martonmiklos/ble_blind_mover/README.md

## BLE blind mover

Control circuit designed to drive a Rollomatic Rollotube Tubular motor.

Design goals:
 - RTC feature for timed blind moving
 - BLE connectivity for programming and RTC sync
 - Integrated isolated 230V power supply for the low voltage parts
