martonmiklos/ble_blind_mover/ble_blind_mover.pdf

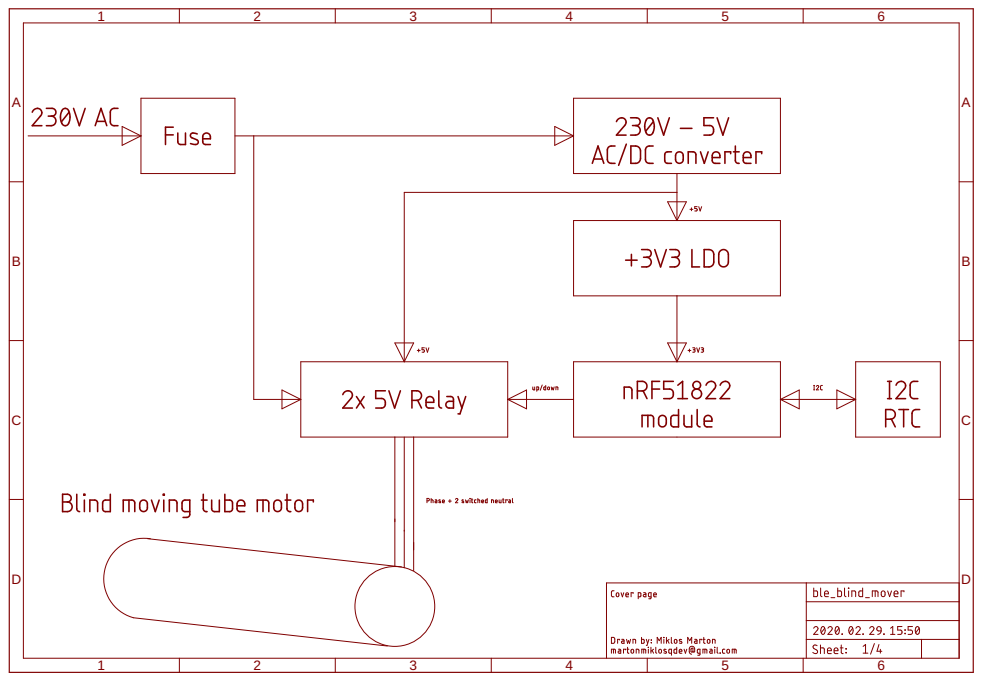
[picture p1: page 1]

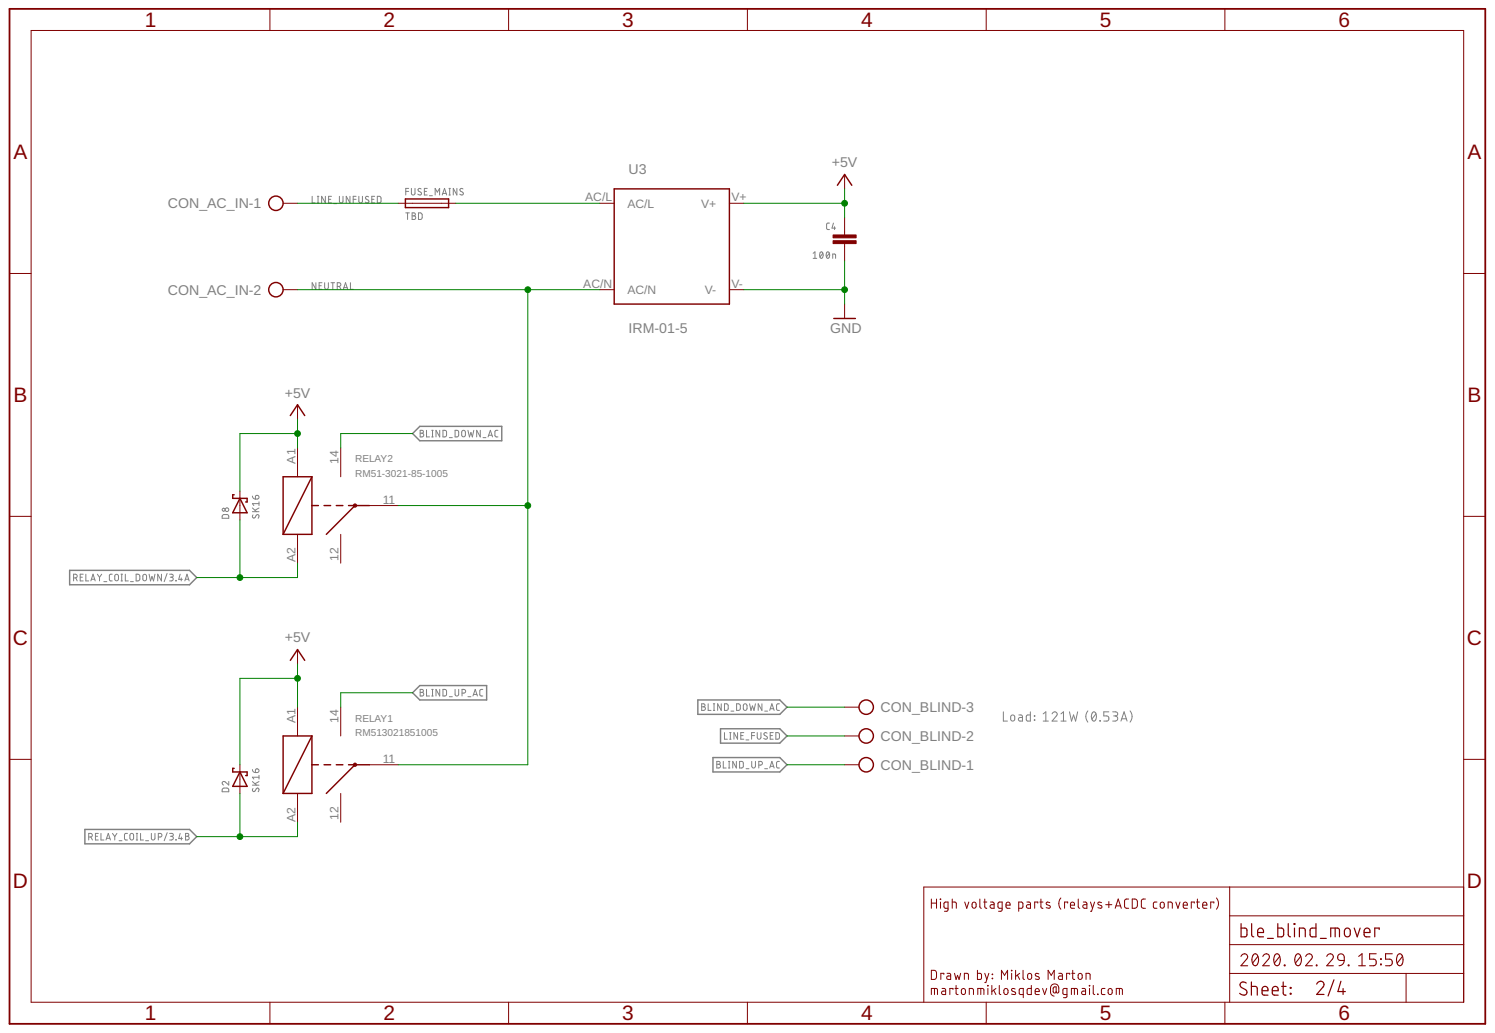
[picture p2: page 2]

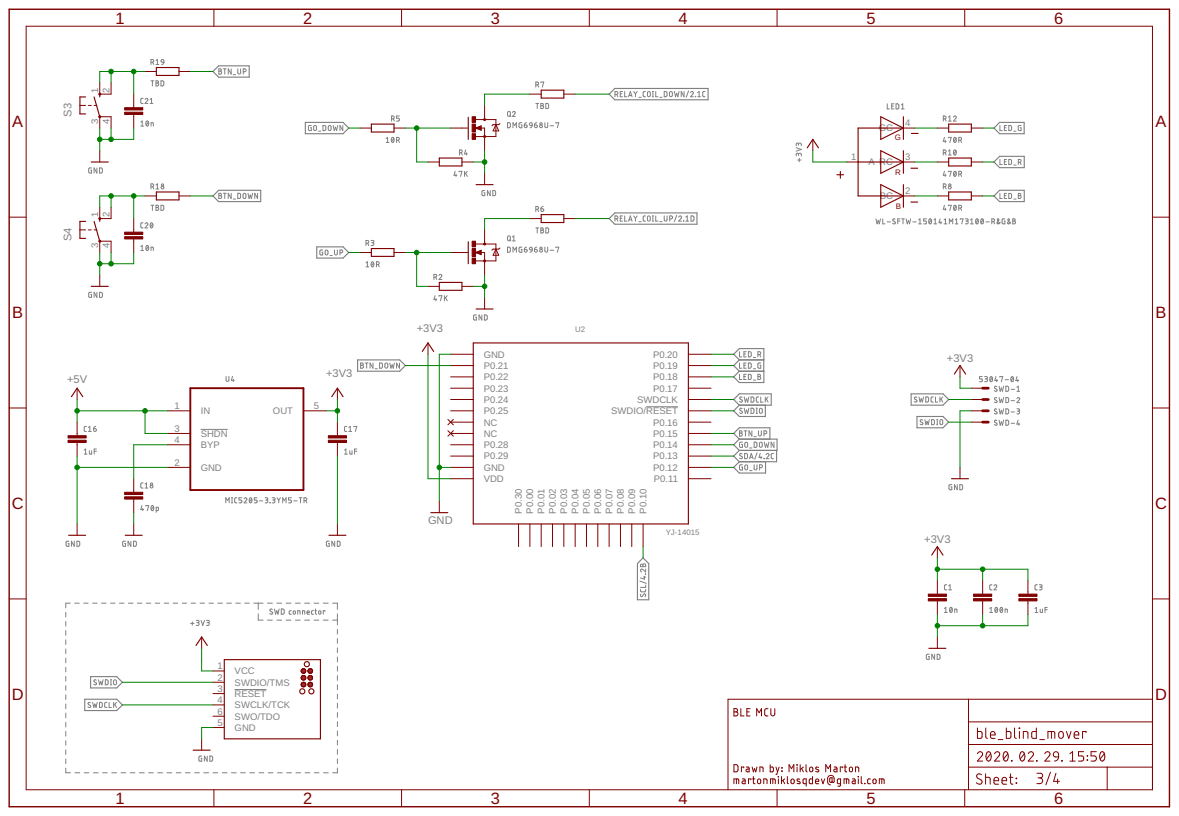
[picture p3: page 3]

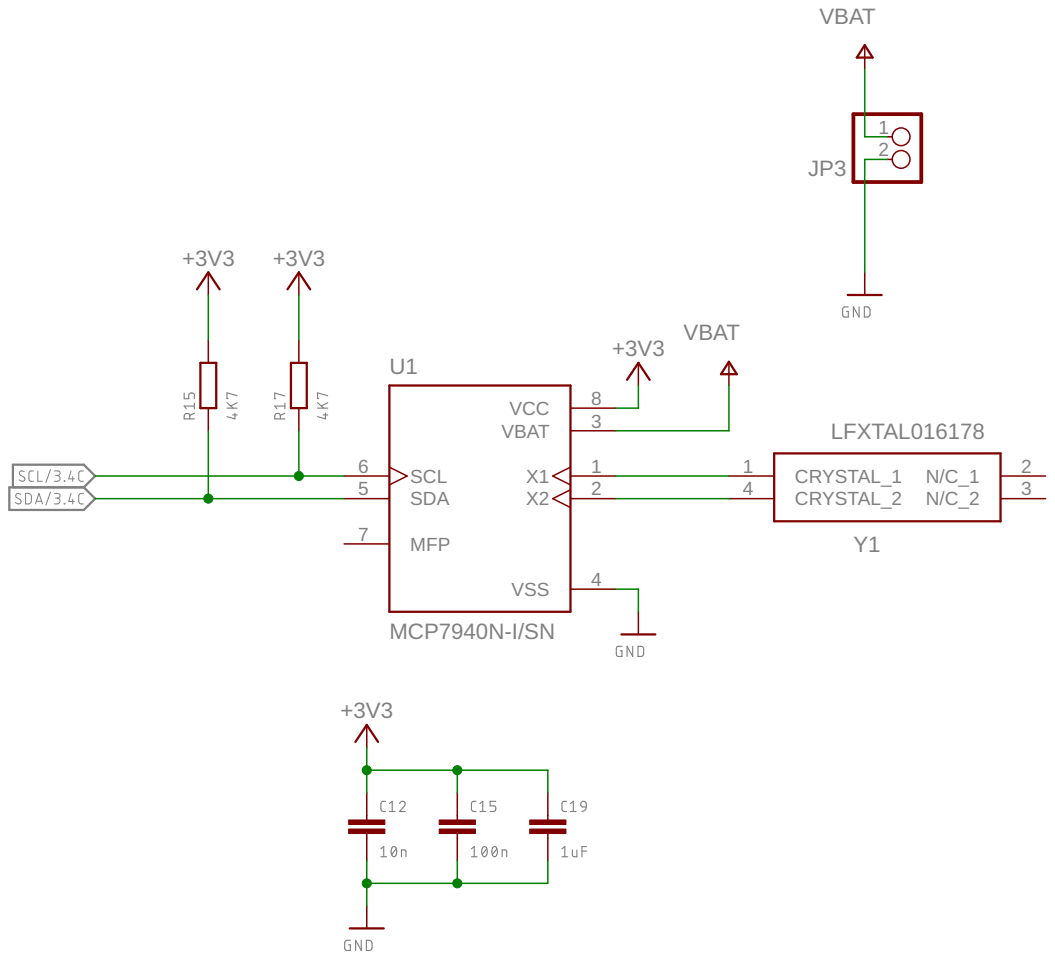
[picture p4: page 4]
