martonmiklos/ble_blind_mover/ble_blind_mover.brd

## EAGLE design ble_blind_mover.brd (2021-05-05)

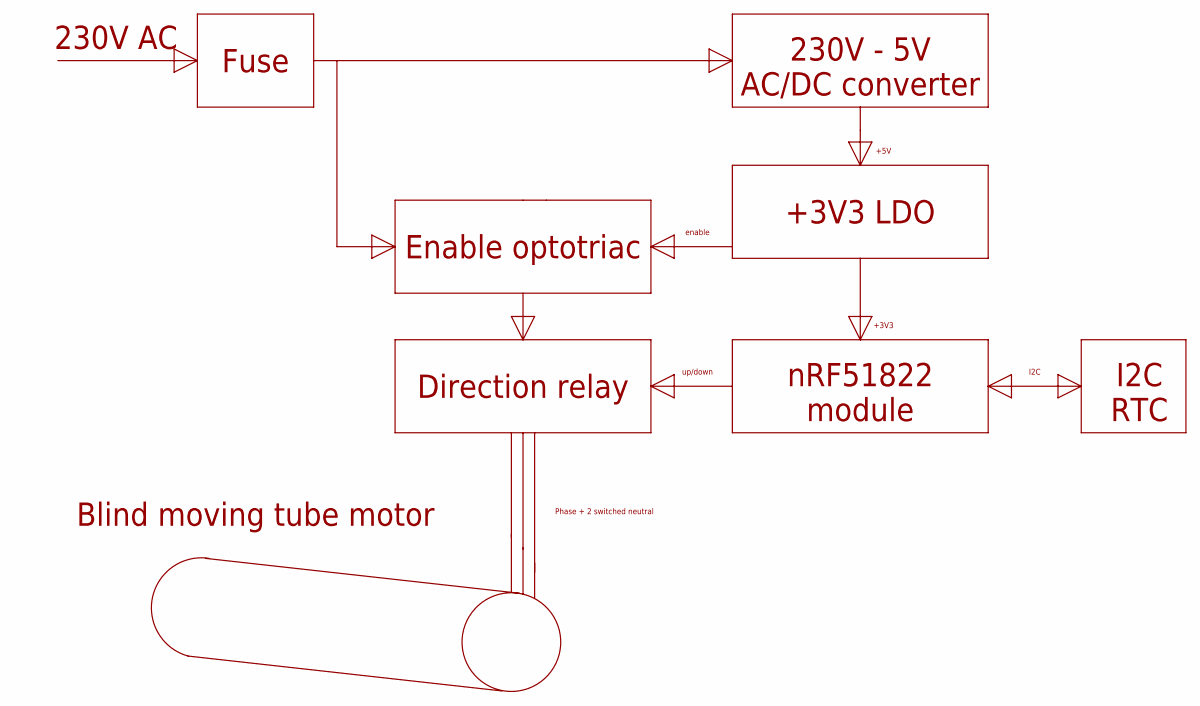
[picture p5: schematic ble_blind_mover.sch, sheet 1, Cover page]

Notes on the sheet:
Fuse
230V AC
230V - 5V AC/DC converter
Direction relay
nRF51822 module
Blind moving tube motor
up/down
+5V
Phase + 2 switched neutral
I2C RTC
I2C
+3V3 LDO
+3V3
Enable optotriac
enable

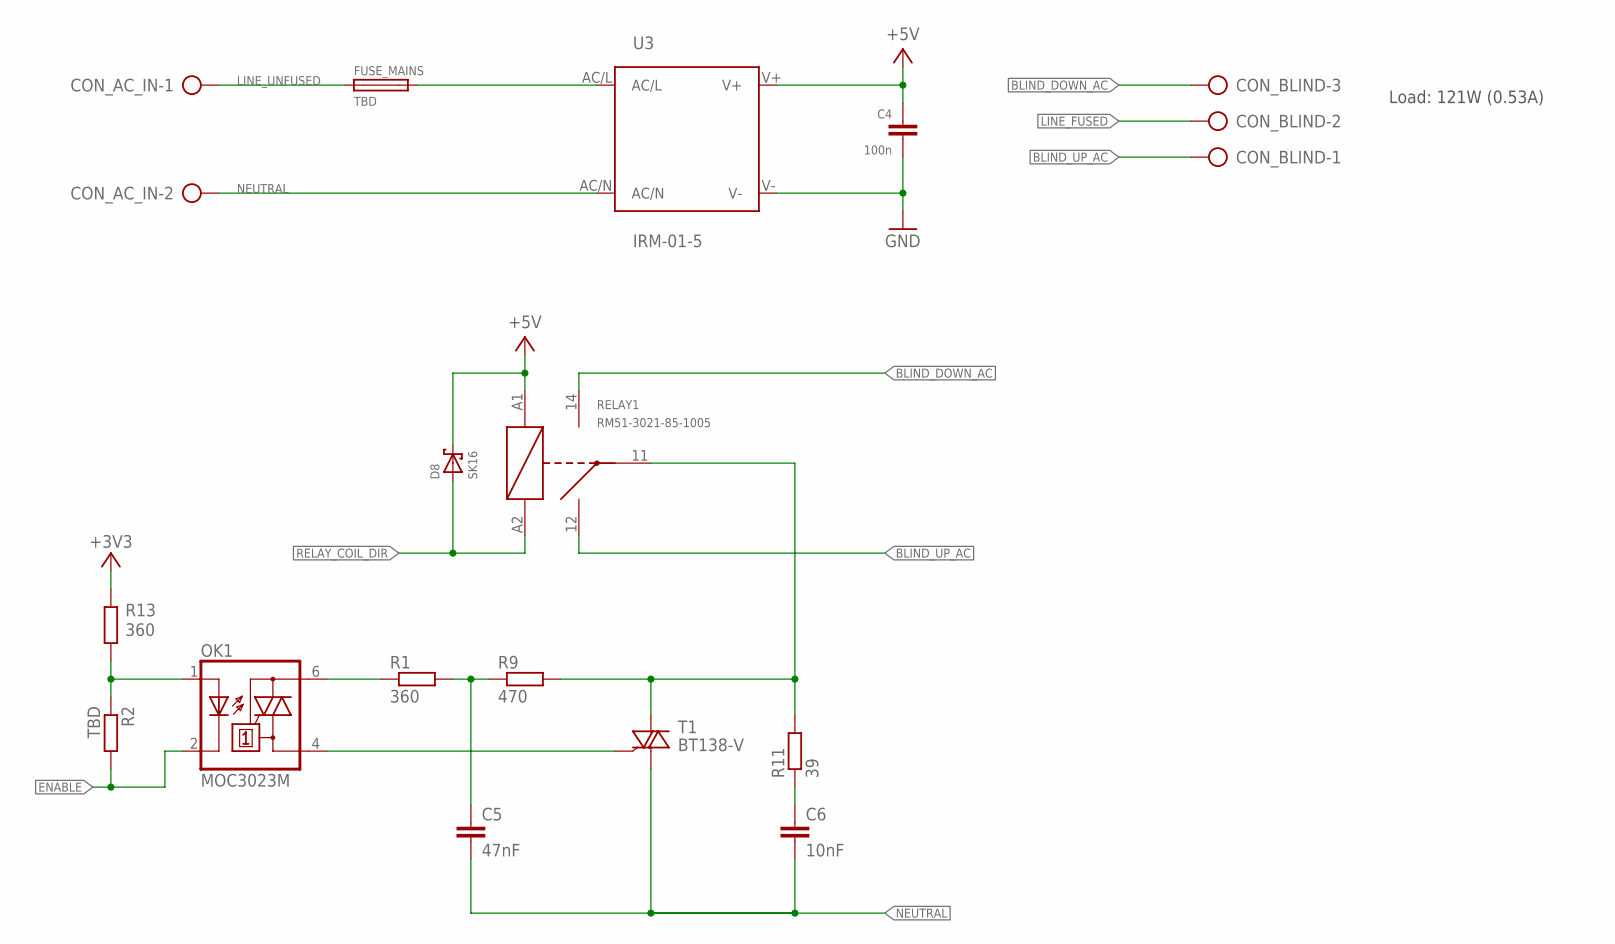
[picture p6: schematic ble_blind_mover.sch, sheet 2, High voltage parts (relays+ACDC converter)]

Parts:
C4: 100n; C0603
C5: 47nF; C025-030X050
C6: 10nF; C025-030X050
CON_AC_IN: AK500/2
CON_BLIND: AK500/3
D8: SK16; DO-214AC
FUSE_MAINS: TBD; SH22,5
OK1: MOC3023M; DIL06
R1: 360; R0805
R2: TBD; R0603
R9: 470; R0805
R11: 39; 0204V
R13: 360; R0603
RELAY1: RM51-3021-85-1005; RM50-3011-XX-XXXX
T1: BT138-V; TO220BV
U3: IRM-01-5; IRM_01/02

Connections:
+3V3: R13.1; also elsewhere on the board
+5V: C4.1, D8.C, RELAY1.A1, U3.V+; also elsewhere on the board
BLIND_DOWN_AC: CON_BLIND.3, RELAY1.14
BLIND_UP_AC: CON_BLIND.1, RELAY1.12
ENABLE: OK1.2 (C), R2.2; also elsewhere on the board
GND: C4.2, U3.V-; also elsewhere on the board
LINE_FUSED: CON_BLIND.2, FUSE_MAINS.2, U3.AC/L
LINE_UNFUSED: CON_AC_IN.1, FUSE_MAINS.1
LOAD_B: R9.2, R11.2, RELAY1.11, T1.T2 (A2)
MOC_AN: OK1.1 (A), R2.1, R13.2
MOC_OUT: OK1.6 (A2), R1.1
unnamed: C5.1, R1.2, R9.1
NEUTRAL: C5.2, C6.2, CON_AC_IN.2, T1.T1 (A1), U3.AC/N
RELAY_COIL_DIR: D8.A, RELAY1.A2; also elsewhere on the board
SNUB_MID: C6.1, R11.1
TRIAC_GET: OK1.4 (A1), T1.G

Notes on the sheet:
Load: 121W (0.53A)

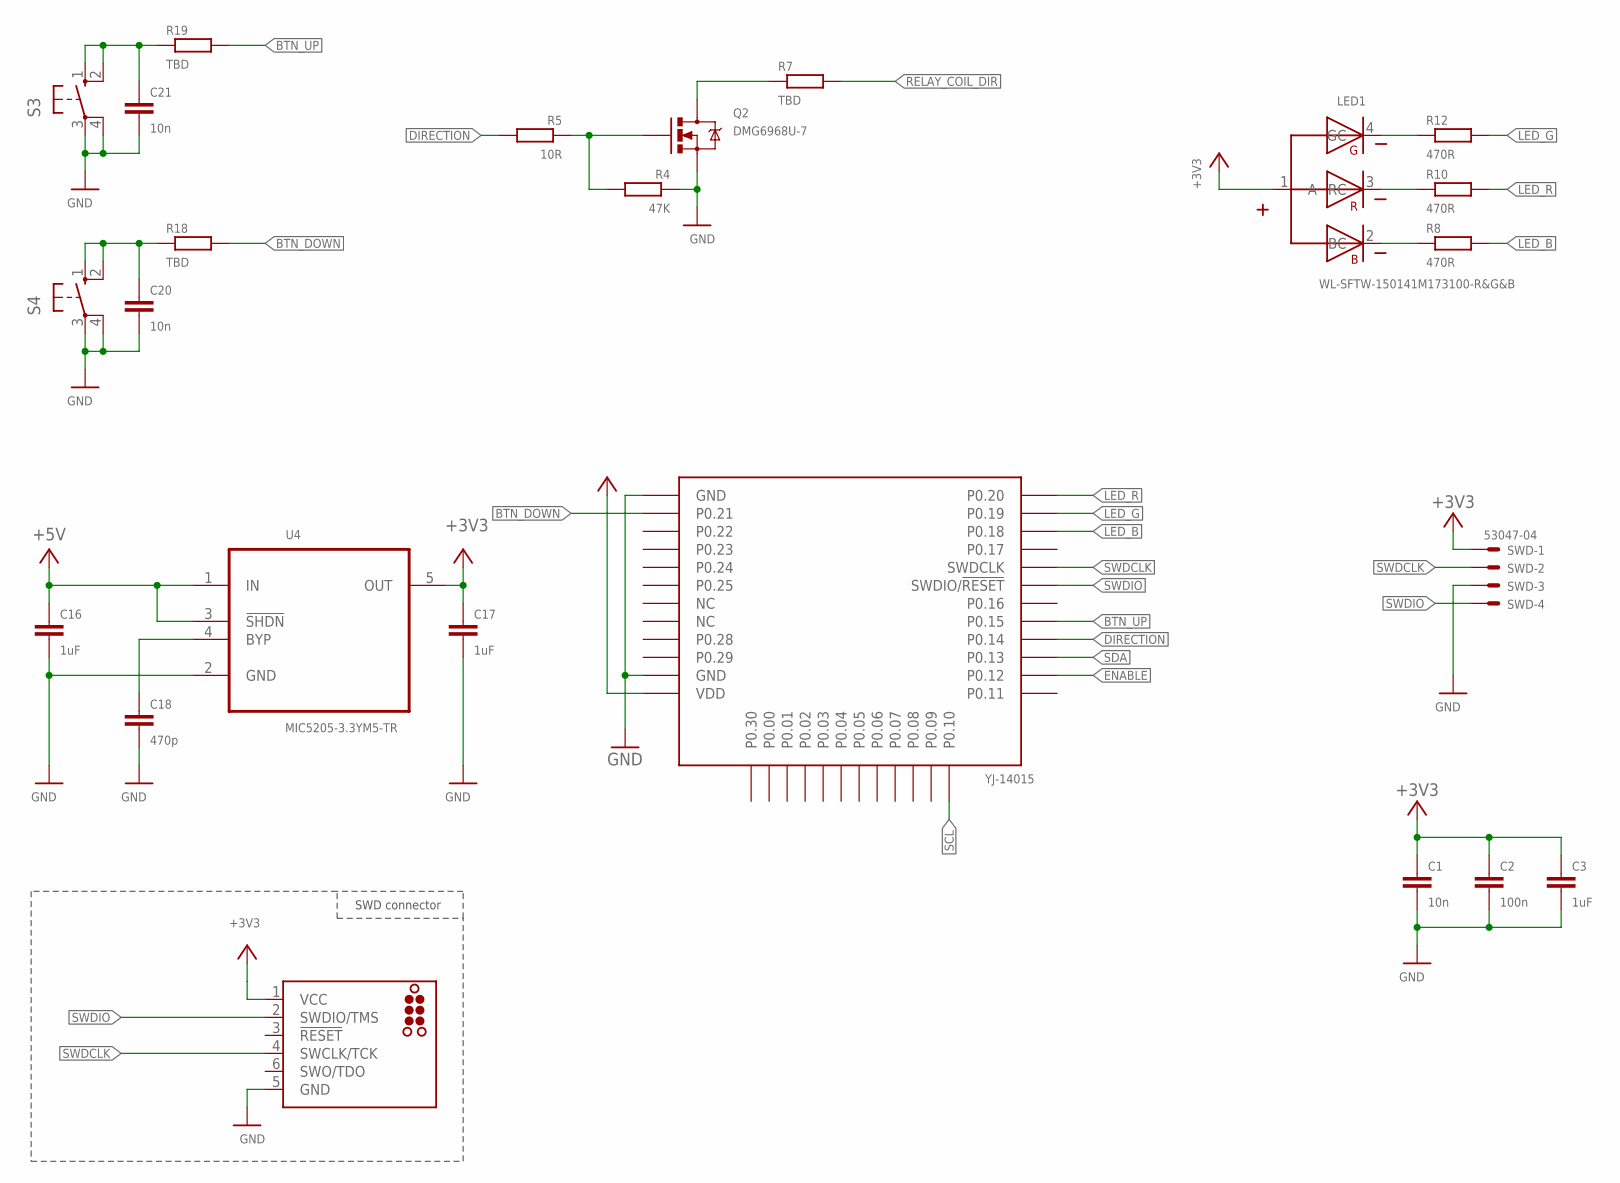
[picture p7: schematic ble_blind_mover.sch, sheet 3, BLE MCU]

Parts:
C1, C20, C21: 10n; C0603
C2: 100n; C0603
C3, C16, C17: 1uF; C0603
C18: 470p; C0603
J2: TC2030_SWD-MCP-NL; TC2030-MCP-NL
LED1: WL-SFTW-150141M173100-R&G&B; 3528-COMMON-ANODE
Q2: DMG6968U-7; SOT23-3
R4: 47K; R0603
R5: 10R; R0603
R7, R18, R19: TBD; R0603
R8, R10, R12: 470R; R0603
S3, S4: 10-XX; B3F-10XX
SWD: 53047-04
U2: YJ-14015
U4: MIC5205-3.3YM5-TR; SOT95P280X145-5N

Connections:
+3V3: C1.1, C2.1, C3.1, C17.1, J2.1 (VCC), LED1.1 (A), SWD.1, U2.VDD, U4.5 (OUT); also elsewhere on the board
+5V: C16.1, U4.1 (IN), U4.3 (!SHDN); also elsewhere on the board
BTN_DOWN: R18.2, U2.P.21 (P0.21)
BTN_DOWN_R: C20.1, R18.1, S4.1 (S), S4.2 (S1)
BTN_UP: R19.2, U2.P.15 (P0.15)
BTN_UP_R: C21.1, R19.1, S3.1 (S), S3.2 (S1)
DIRECTION: R5.2, U2.P.14 (P0.14)
ENABLE: U2.P.12 (P0.12); also elsewhere on the board
GND: C1.2, C2.2, C3.2, C16.2, C17.2, C18.2, C20.2, C21.2, J2.5 (GND), Q2.2 (S), R4.1, S3.3, S3.4 (P1), S4.3, S4.4 (P1), SWD.3, U2.GND, U2.GND@2 (GND), U4.2 (GND); also elsewhere on the board
LED2_B_R: LED1.2 (BC), R8.1
LED2_G_R: LED1.4 (GC), R12.1
LED2_R_R: LED1.3 (RC), R10.1
LED_B: R8.2, U2.P.18 (P0.18)
LED_G: R12.2, U2.P.19 (P0.19)
LED_R: R10.2, U2.P.20 (P0.20)
MOTOR_B_GATE_R: Q2.1 (G), R4.2, R5.1
RELAY_COIL_DIR: R7.2; also elsewhere on the board
RELAY_COIL_DIR_R: Q2.3 (D), R7.1
SCL: U2.P.10 (P0.10); also elsewhere on the board
SDA: U2.P.13 (P0.13); also elsewhere on the board
SWDCLK: J2.4 (SWCLK/TCK), SWD.2, U2.SWDCLK
SWDIO: J2.2 (SWDIO/TMS), SWD.4, U2.SWDIO (SWDIO/!RESET)
U4_BYPASS: C18.1, U4.4 (BYP)

Notes on the sheet:
SWD connector

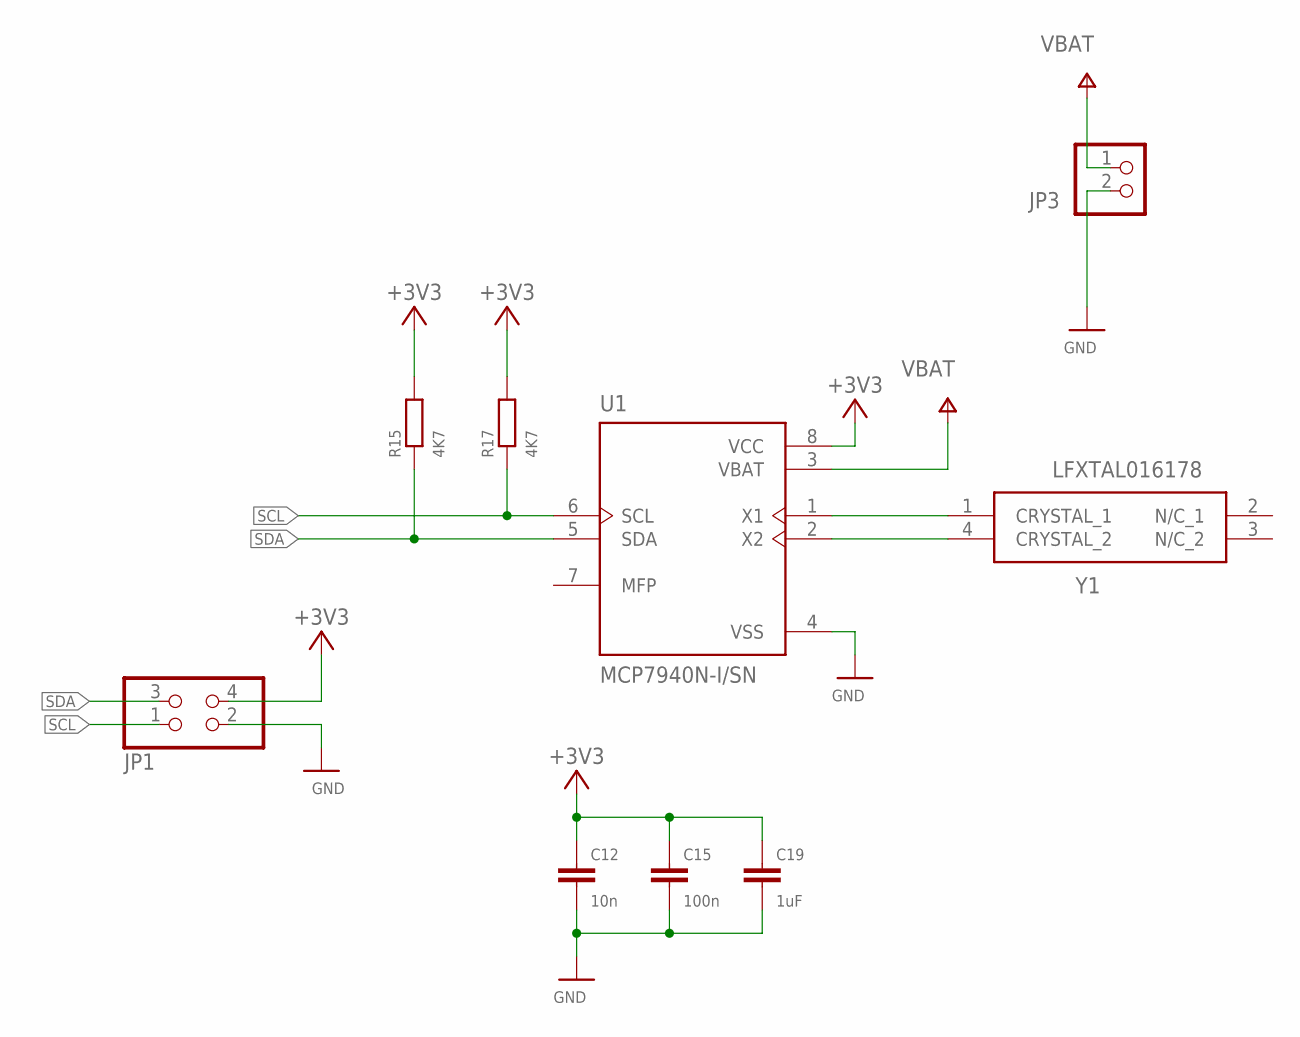
[picture p8: schematic ble_blind_mover.sch, sheet 4, I2C RTC]

Parts:
C12: 10n; C0603
C15: 100n; C0603
C19: 1uF; C0603
JP1: PINHD-2X2; 2X02
JP3: PINHD-1X2; 1X02
R15, R17: 4K7; R0603
U1: MCP7940N-I/SN; SOIC127P600X175-8N
Y1: LFXTAL016178; LFXTAL016178_1

Connections:
+3V3: C12.1, C15.1, C19.1, JP1.4, R15.2, R17.2, U1.8 (VCC); also elsewhere on the board
GND: C12.2, C15.2, C19.2, JP1.2, JP3.2, U1.4 (VSS); also elsewhere on the board
RTC_XTAL1: U1.1 (X1), Y1.1 (CRYSTAL_1)
RTC_XTAL2: U1.2 (X2), Y1.4 (CRYSTAL_2)
SCL: JP1.1, R17.1, U1.6 (SCL); also elsewhere on the board
SDA: JP1.3, R15.1, U1.5 (SDA); also elsewhere on the board
VBAT: JP3.1, U1.3 (VBAT)

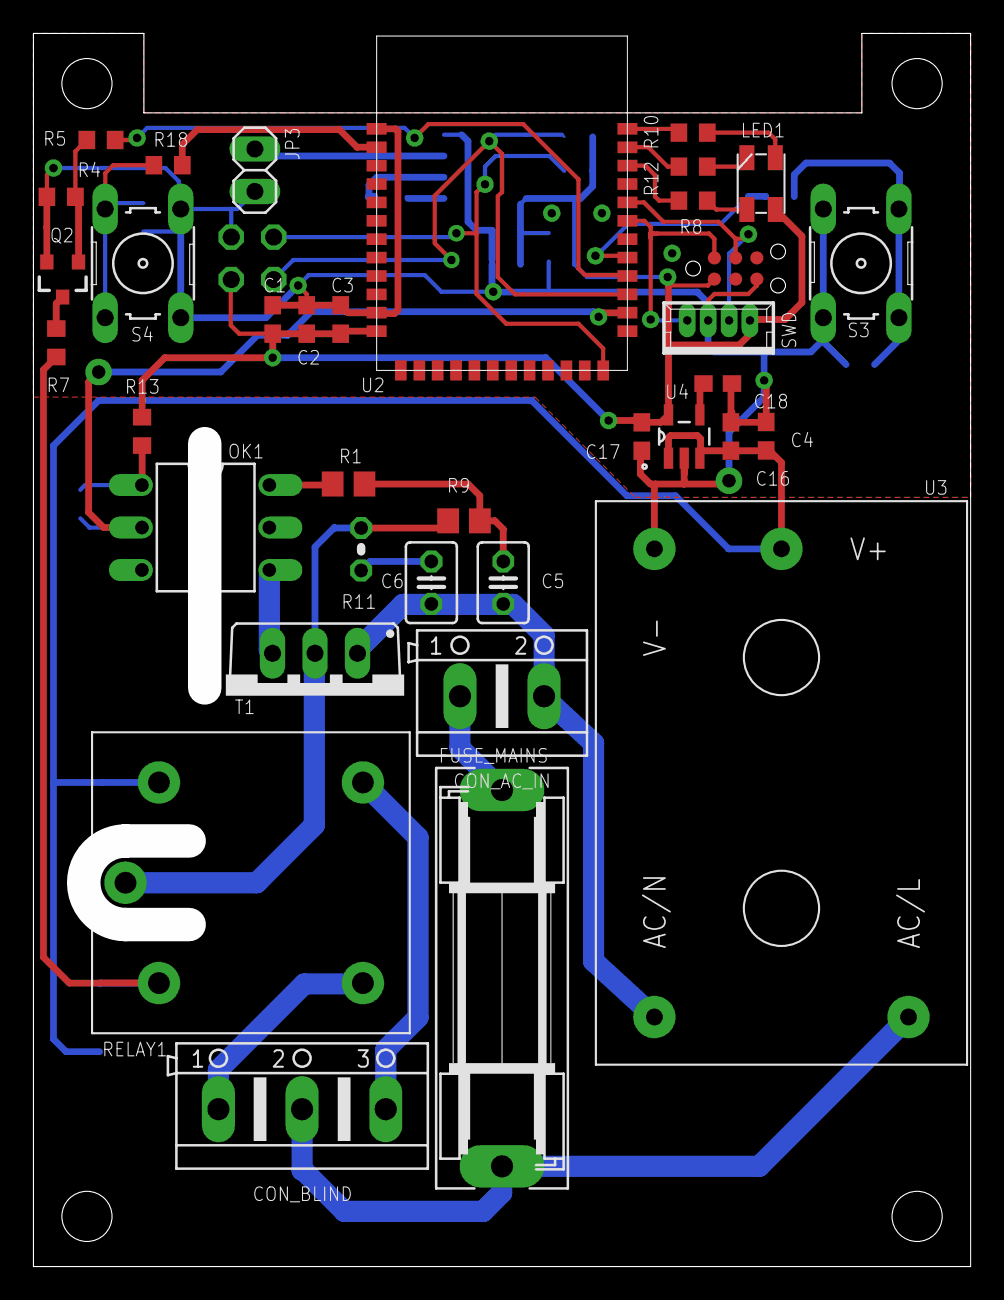
[picture p9: board ble_blind_mover.brd from above]

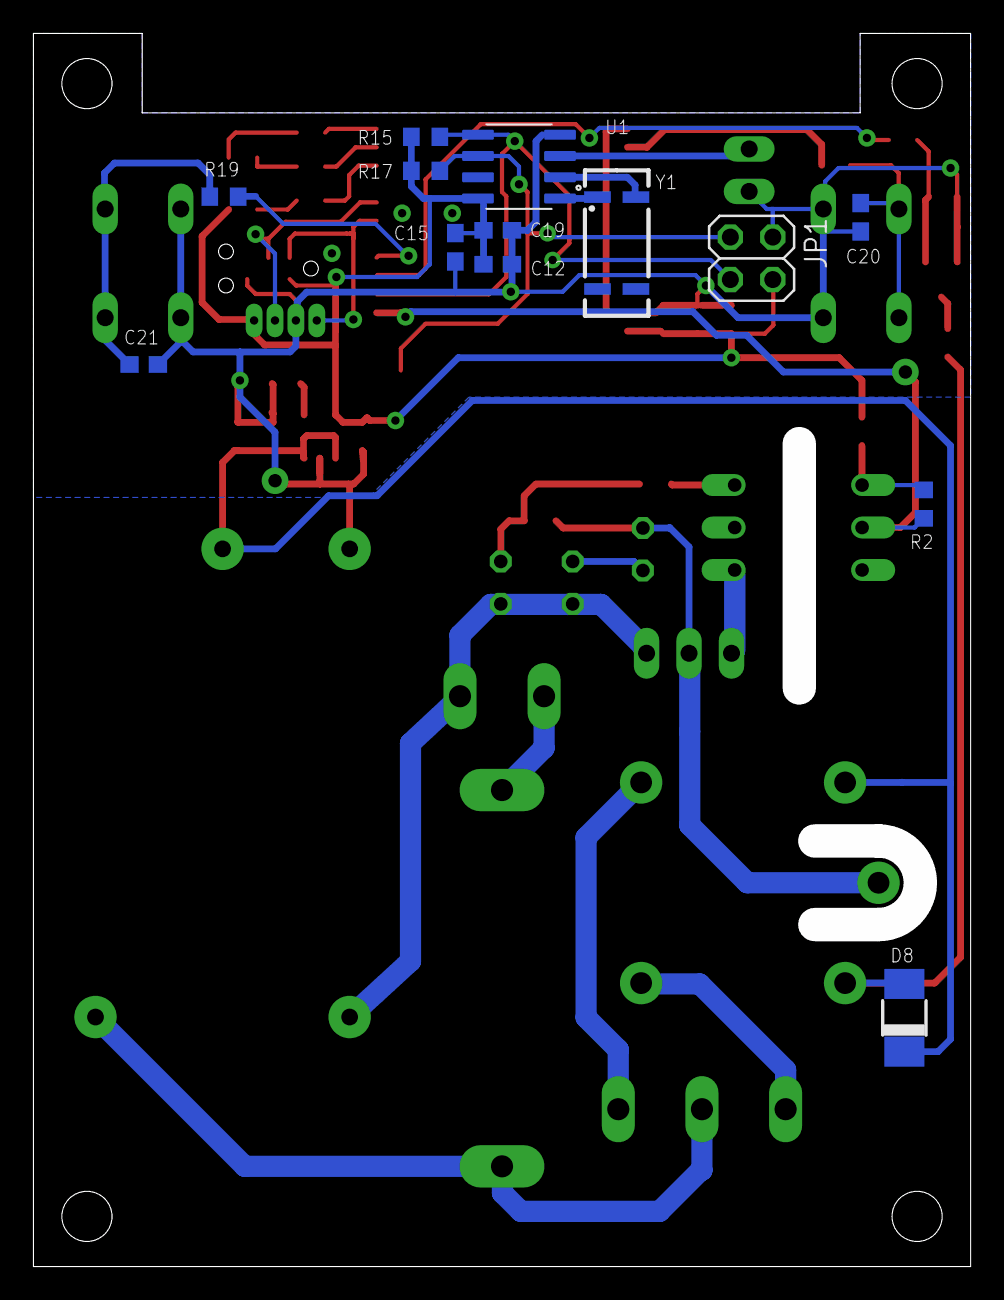
[picture p10: board ble_blind_mover.brd from below]

Board: 2 copper layers, 56.0 x 73.8 mm, 49 parts (13 on the bottom side), 37 nets.
