martonmiklos/ble_blind_mover/(threads)

Thread 1 (2019-11-28):

Biasing circuit

martonmiklos, 2019-11-28:
Lower idle current consumption can be reached by external biasing which is more important in our case than the BoM cost. This will require to reconfigure the Viper to 5V and adding a linear regulator for the 3V3.
