martonmiklos/ble_blind_mover/(commit log)

2019-10-31 Working on SCH
    [redony.sch]
2019-11-02 Naming all nets
    [ble_blind_mover.sch]
2019-11-28 Daily save
    [ble_blind_mover.brd, ble_blind_mover.sch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]
2019-12-03 Brd routed, clearance adjustment still WIP
    [ble_blind_mover.brd, ble_blind_mover.sch]
2019-12-04 Fixed board eouting for increased low/high voltage clearance
    [ble_blind_mover.brd, ble_blind_mover.sch]
2019-12-05 Added power connecting pinheads
    [ble_blind_mover.brd, ble_blind_mover.sch]
2020-02-29 Aligned silkscreen labels
    [ble_blind_mover.brd, ble_blind_mover.sch]
2020-02-29 Added RTC
    [ble_blind_mover.brd, ble_blind_mover.sch]
2020-02-29 - Add RTC to cover page - Add schematic PDF to the repo
    [ble_blind_mover.brd, ble_blind_mover.sch]
2020-02-29 - Get rid from Viper PSU in favour of a Meanwell module - Make the contours to fit in a Kradex Z21 box
    [ble_blind_mover.brd, ble_blind_mover.sch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]
2020-04-23 MOved to a triac based design
    [ble_blind_mover.brd, ble_blind_mover.sch]
2021-05-05 Added B2B connector for I2C
    [ble_blind_mover.brd, ble_blind_mover.sch]
