martonmiklos/ble_blind_mover/(notices)

Notices in the files:
parts and their libraries:
relay-relpol: (C) 2014 Tomasz Boleslaw CEDRO, cederom@tlen.pl, http://www.tomek.cedro.info.
SparkFun: Licensing: CC v3.0 Share-Alike You are welcome to use this library for commercial purposes.
Wurth_Elektronik_Optoelectronics_rev15b: Copyright: Würth Elektronik
